juandelacruz-calvo/INDX-Voron-Y-endstop/images/parts.png

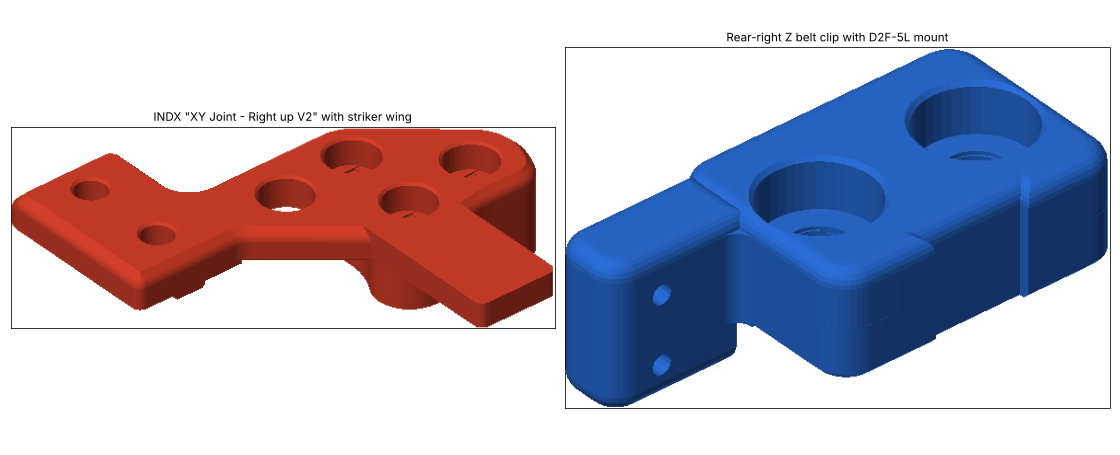
images/parts.png
