juandelacruz-calvo/INDX-Voron-Y-endstop/cad/source_stl/INDX XY Joint - Right up V2.stl

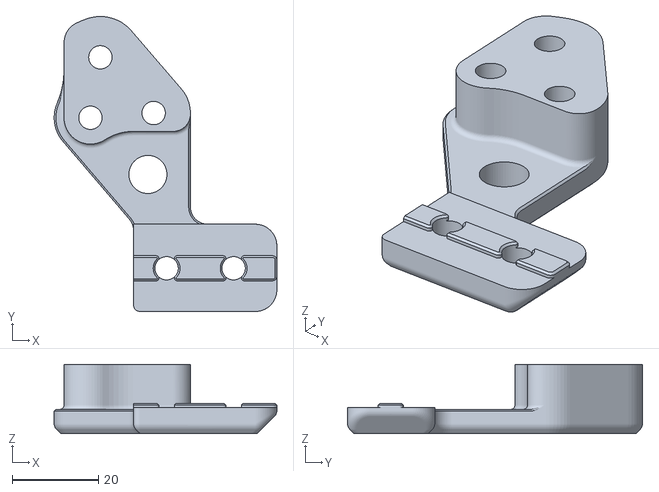
[picture p4: CAD file, 2026-11-09]
cad/source_stl/INDX XY Joint - Right up V2.stl
51.5 x 68.2 x 16.0
