juandelacruz-calvo/INDX-Voron-Y-endstop/stl/INDX XY Joint - Right up V2 - Y endstop.stl

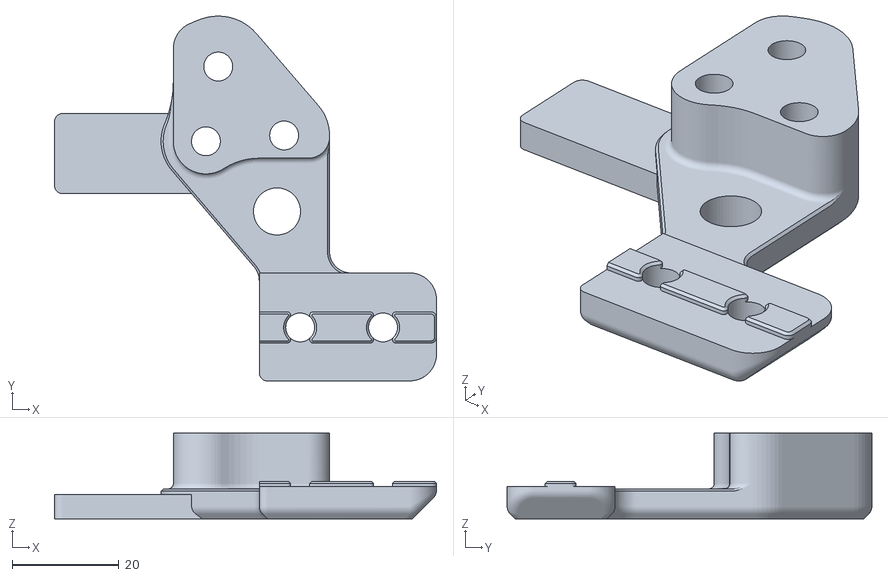
[picture p5: CAD file, 2026-11-09]
stl/INDX XY Joint - Right up V2 - Y endstop.stl
71.5 x 68.2 x 16.0
