juandelacruz-calvo/INDX-Voron-Y-endstop/cad/source_stl/voron_z_belt_clip_upper.stl

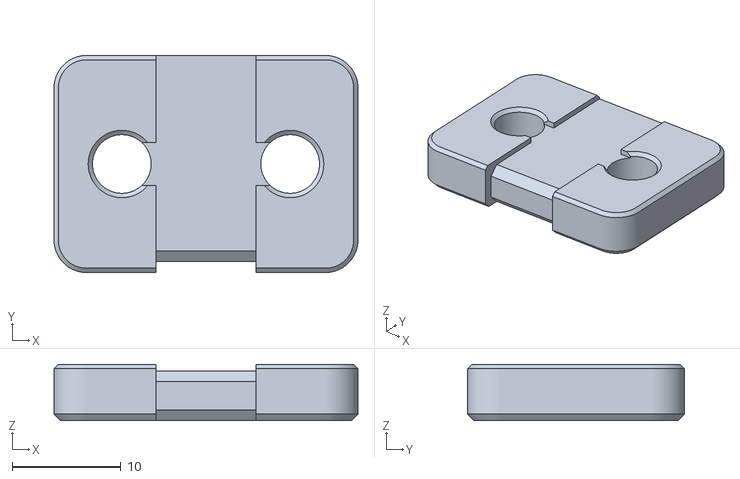
[picture p6: CAD file, 2026-11-09]
cad/source_stl/voron_z_belt_clip_upper.stl
28.0 x 20.0 x 5.20
