juandelacruz-calvo/INDX-Voron-Y-endstop/stl/z_belt_clip_upper_rear_right_y_endstop.stl

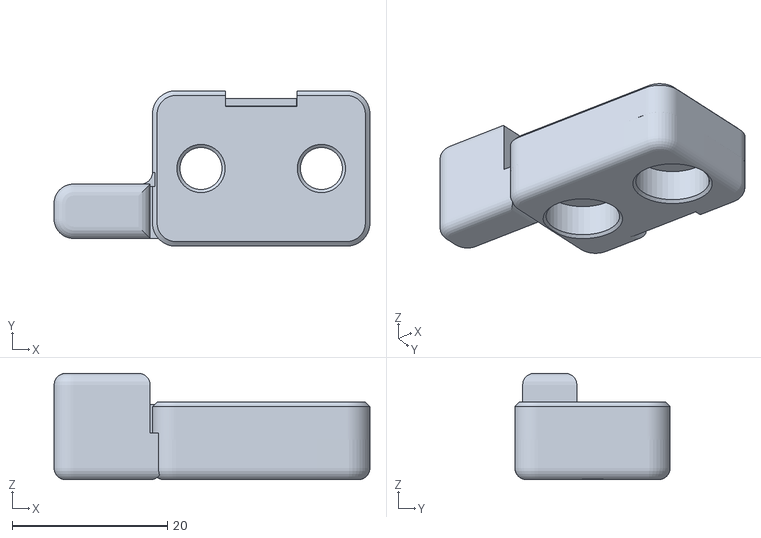
[picture p7: CAD file, 2026-11-09]
stl/z_belt_clip_upper_rear_right_y_endstop.stl
40.7 x 20.0 x 13.7
