juandelacruz-calvo/INDX-Voron-Y-endstop/images/print_orientation.png

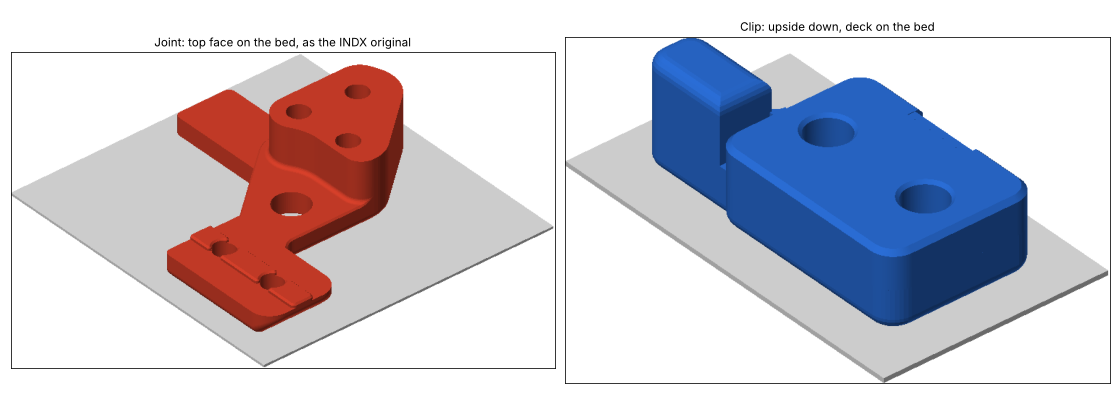
images/print_orientation.png
