juandelacruz-calvo/INDX-Voron-Y-endstop/(commit log)

2026-11-09 INDX Voron 2.4 rear Y endstop: joint wing + Z belt clip D2F mount
    Two replacement parts for a Voron 2.4 with INDX and an umbilical:
    - INDX "XY Joint - Right up V2" with a striker wing on its outboard rear edge
    - rear-right Voron Z belt clip holding an Omron D2F-5L upright
    STLs (watertight bodies over the untouched originals), OpenSCAD source
    with the original GPLv3 meshes, renders, and a full README covering
    printing, installation, Klipper setup, design notes and verification.
    [INDX XY Joint - Right up V2 - Y endstop.stl, INDX XY Joint - Right up V2.stl, indx_rear_y_endstop.scad, voron_z_belt_clip_upper.stl, z_belt_clip_upper_rear_right_y_endstop.stl]
2026-11-09 README: Voron 2.4 with INDX, compatible with GE5C Z joints
